ronaldsieber/LoraAmbientMonitor/Documentation/LoRa_Payload_Design.pdf

Value | Size [Bit] | Data Range | Value Range
B7 | B6 | B5 | B4 | B3 | B2 | B1 | B0
+0 | PacketType | 4 | 0 … 15 | 0 … 15
+1 | DevID | 4 | 0 … 15 | 0 … 15
+2 | SequNum | 24 | 0 … 16777216 | 0 … 16777216
+3 | Uptime | 32 | 0 … 4294967296 [sec] | 0 … 136 [year]
+4 | CRC16 | 16
+5
+6
+7
+8
+9
B7 | B6 | B5 | B4 | B3 | B2 | B1 | B0
+10 | PacketType | 4 | 0 … 15 | 0 … 15
+11 | UptimeSnippet | 12 | 0 … 4095 [10 sec] | 0 … 11 [h]
+12 | Temperature | 8 | -128 … 127 [0.5 °C] | -64.0 … 63.5 [ °C]
+13 | MotionActive | Humidity | 7 | 0 … 127 [%] | 0 … 100 [%]
+14 | MotionActive | 1 | true | false | true | false
+15 | MotionActiveTime | 8 | 0 … 255 [10 sec] | 0 … 42 [min]
+16 | MotionActiveCount | 10 | 0 … 1023 | 0 … 1023
+17 | LightLevel | 6 | 0 … 63 [2 %] | 0 … 100 [%]
+18 | CarBattLevel | 8 | 0 … 255 [0.1 V] | 0 … 25.5 [V]
+19 | CRC16 | 16
B7 | B6 | B5 | B4 | B3 | B2 | B1 | B0
+20 | PacketType | 4 | 0 … 15 | 0 … 15
+21 | UptimeSnippet | 12 | 0 … 4095 [10 sec] | 0 … 11 [h]
+22 | Temperature | 8 | -128 … 127 [0.5 °C] | -64.0 … 63.5 [ °C]
+23 | MotionActive | Humidity | 7 | 0 … 127 [%] | 0 … 100 [%]
+24 | MotionActive | 1 | true | false | true | false
+25 | MotionActiveTime | 8 | 0 … 255 [10 sec] | 0 … 42 [min]
+26 | MotionActiveCount | 10 | 0 … 1023 | 0 … 1023
+27 | LightLevel | 6 | 0 … 63 [2 %] | 0 … 100 [%]
+28 | CarBattLevel | 8 | 0 … 255 [0.1 V] | 0 … 25.5 [V]
+29 | CRC16 | 16
B7 | B6 | B5 | B4 | B3 | B2 | B1 | B0
+30 | PacketType | 4 | 0 … 15 | 0 … 15
+31 | UptimeSnippet | 12 | 0 … 4095 [10 sec] | 0 … 11 [h]
+32 | Temperature | 8 | -128 … 127 [0.5 °C] | -64.0 … 63.5 [ °C]
+33 | MotionActive | Humidity | 7 | 0 … 127 [%] | 0 … 100 [%]
+34 | MotionActive | 1 | true | false | true | false
+35 | MotionActiveTime | 8 | 0 … 255 [10 sec] | 0 … 42 [min]
+36 | MotionActiveCount | 10 | 0 … 1023 | 0 … 1023
+37 | LightLevel | 6 | 0 … 63 [2 %] | 0 … 100 [%]
+38 | CarBattLevel | 8 | 0 … 255 [0.1 V] | 0 … 25.5 [V]
+39 | CRC16 | 16

Uptime

CRC16

CarBattLevel
CRC16
CRC16
PacketType | UptimeSnippet
PacketType | UptimeSnippet

UptimeSnippet
Temperature
Humidity
MotionActiveTime
MotionActiveCount
MotionActiveCount | LightLevel

SequNum

PacketType | DevD

Uptime

MotionActiveTime

Temperature

Uptime

CRC16
CRC16

UptimeSnippet

PacketType

SequNum
SequNum

Uptime

UptimeSnippet

Humidity

CRC16

CRC16

MotionActiveCount

CarBattLevel
CRC16
MotionActiveCount | LightLevel

Temperature

UptimeSnippet

Humidity

MotionActiveCount | LightLevel
CarBattLevel

MotionActiveTime
MotionActiveCount
